thieu-b55/ESP32-clock-radio-with-web-interface/README.md

# ESP32-clock-radio

Fully operable via web page, only 1 push button to turn off the alarm 

*

Clock

Large and clear display.

Internal clock synchronized 2 x day with NTP server.

Time zone and winter / summer time correction manually via web page.

Adjustable clock display brightness.

*

clock radio

3 programmable alarms

* certain day
 
* daily

* weekdays

* weekend

mp3 player or internet radio as alarm source.

Possibility to be awakened by a freely selectable wake-up call.

Automatically turns off after 1 hour.

*

Internet radio

10 pre-programmed internet radios, can be changed via web page.

Tone and Volume control.

Continuous operation or as an alarm.

Random mp3 player 5000+ mp3 files without problem.
