thieu-b55/ESP32-clock-radio-with-web-interface/ESP32 wekkerradio(EN).pdf

## ESP32 clock - clock radio - internet radio / MP3 player -

control via web page.

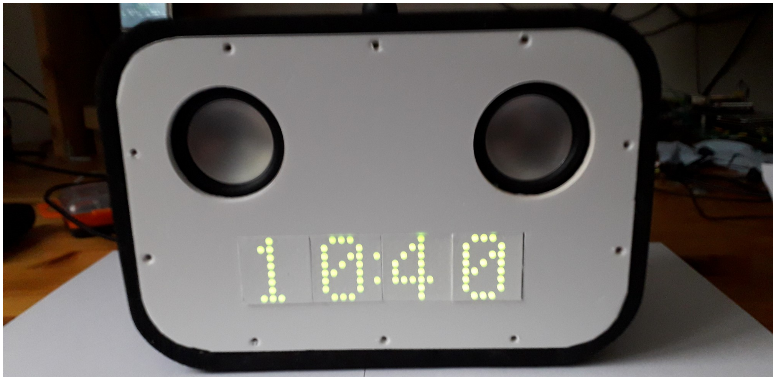
[picture p1: figure]

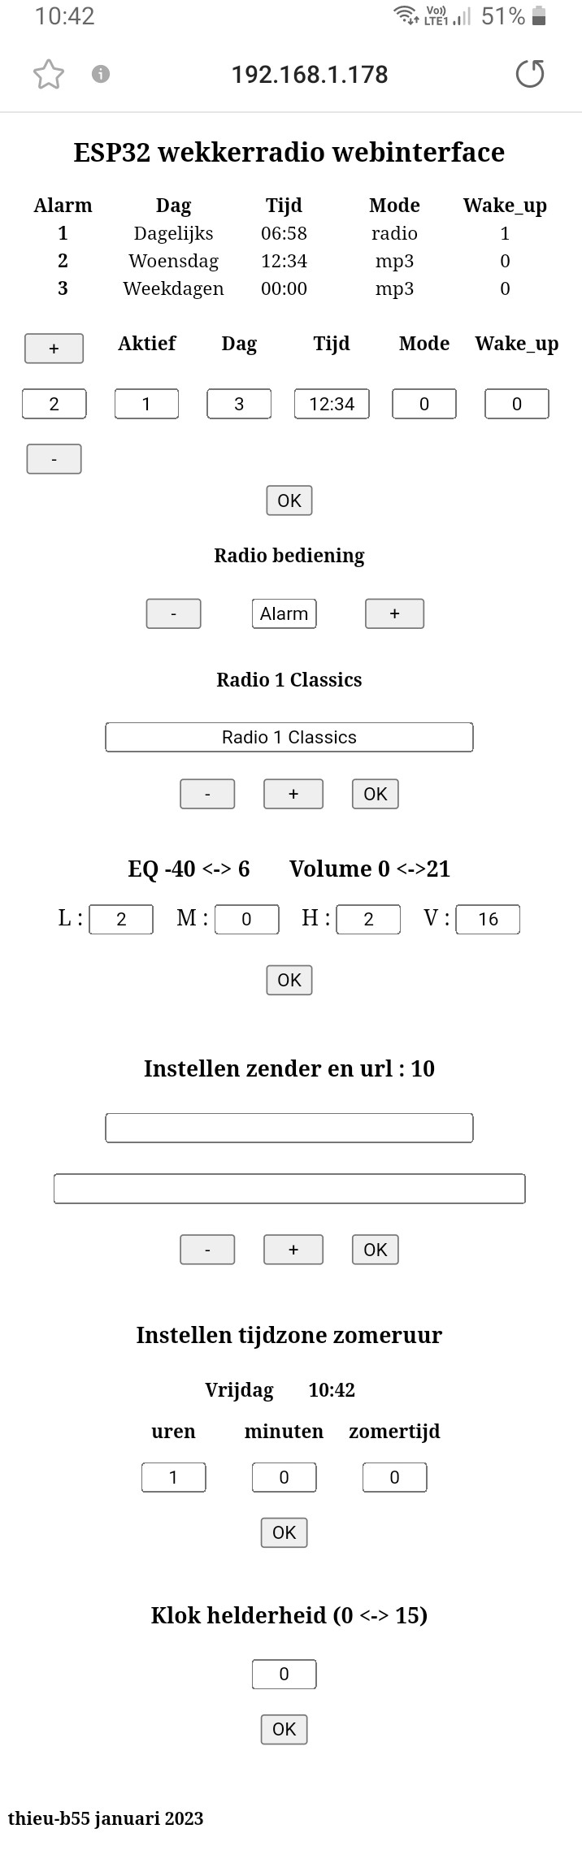
[picture p2: figure]

Clock
Large and clear display.
Internal clock synchronized 2 x day with NTP server.
Time zone and winter / summer time correction manually via web page. Adjustable clock display brightness.

clock radio
3 programmable alarms
* certain day
* daily
* weekdays
*weekend
mp3 player or internet radio as alarm source.
Possibility to be awakened by a freely selectable wake-up call. Automatically turns off after 1 hour.

Internet radio
10 pre-programmed internet radios, can be changed via web page. Tone and Volume control.
Continuous operation or as an alarm.
Random mp3 player 5000+ mp3 files without problem.

What do we need

ESP32-WROOM (38 pin versie)

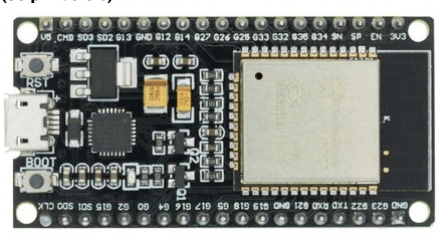
[picture p3: figure]

https://nl.aliexpress.com/item/32864722159.html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 %213.71%213.71%21%21%21%21%21%40210212c016740610529416210d0669%211200002874 4589167%21sea&curPageLogUid=wgT9nNbq322I (https://nl.aliexpress.com/item/32864722159.html?curPageLogUid=wgT9nNbq322I)

PCM5102A

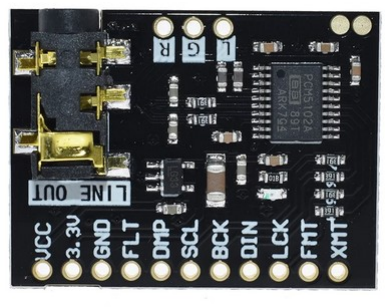
[picture p4: figure]

https://nl.aliexpress.com/item/33004561102.html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 %215.76%211.44%21%21%21%21%21%40212244c416740698615196556d0685%216711868056 6%21sea&curPageLogUid=zWKmpHWXxf05 (https://nl.aliexpress.com/item/33004561102.html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)

SD card module

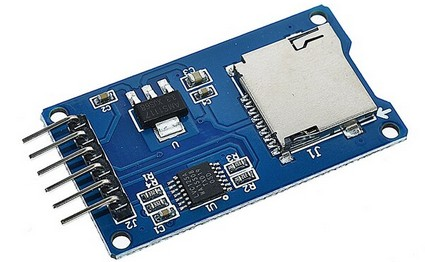
[picture p5: figure]

https://nl.aliexpress.com/item/32523546123.html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 %210.64%210.52%21%21%21%21%21%40212240a316740612452115676d0665%211000000248 6114694%21sea&curPageLogUid=oi29kmat1NDl (https://nl.aliexpress.com/item/32523546123.html?curPageLogUid=oi29kmat1NDl)

SD card FAT32 formatted
Depends on number of mp3 files, otherwise minimal size is sufficient.

DS3231 RTC

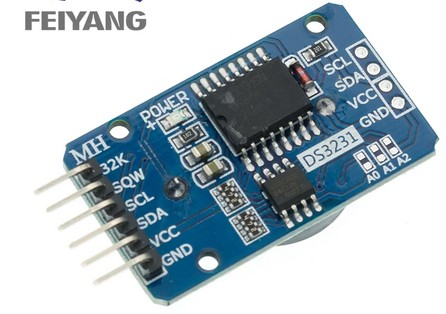
[picture p6: figure]

https://nl.aliexpress.com/item/32833136577.html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 %212.1%212.1%21%21%21%21%21%4021227a0f16740613309012224d06b3%2167454834461% 21sea&curPageLogUid=kFy3BkroDl2w (https://nl.aliexpress.com/item/32833136577.html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)

MAX7219 module

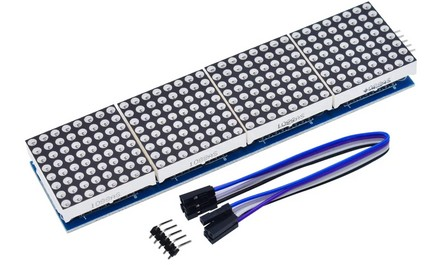
[picture p7: figure]

https://nl.aliexpress.com/item/4000587266290.html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 %214.49%213.69%21%21%21%21%21%402102111816740614473856175d0688%211000000343 9612437%21sea&curPageLogUid=RUunHGplwHcQ (https://nl.aliexpress.com/item/4000587266290.html?curPageLogUid=RUunHGplwHcQ)

Glasfolie wit mat
dimming brightness MAX7219 module https://www.gamma.be/nl/assortiment/decoratiefolie-mat-wit-346-0001-45x200cm/p/B389981

5V stereo versterker

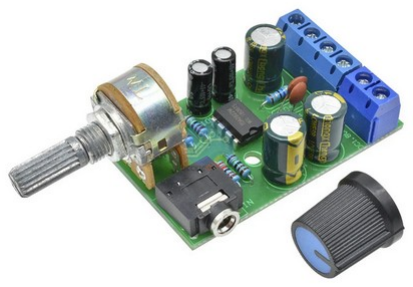
[picture p8: figure]

https://nl.aliexpress.com/item/32791319633.html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 %212.17%211.41%21%21%21%21%21%4021021aa216740618720378241d0701%216365064057 8%21sea&curPageLogUid=elbg0VoJ1Wxb (https://nl.aliexpress.com/item/32791319633.html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)

### 2 x luidspreker

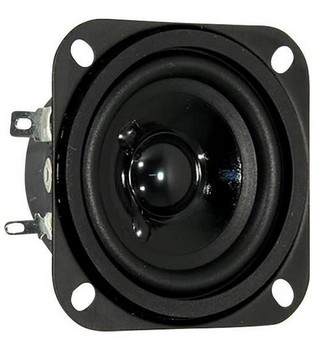
[picture p9: figure]

https://www.allekabels.be/luidspreker-zelfbouw/237/1370099/full-range-speaker-58-cm-23-8-10-w.html (https://www.allekabels.be/luidspreker-zelfbouw/237/1370099/full-range-speaker-58-cm-23-8-10-w.html)

Mosfet IRL540 / IRF540
IRL540L Vgs(th) | 1.0V | 2.0V
IRF540F Vgs(th) | 2.0V | 4.0V

IRF540 does what it should do, but if in stock IRL540 is recommended

R 1K
R 4K7

Pushbutton

5V (USB)power supply

1 x smartphone for operating radio / clock radio.

Internet connection is necessary

Connections

5V power supply
+5V | 5V | ESP32-WROOM
VCC | PCM5102A
VCC | MAX7219
DC+ | amplifier
GND | GND | ESP32-WROOM | 3X
GND | PCM5102A
GND | SD module
GND | RTC DS3231
GND | MAX7219
Source IRF(IRL)540 | amplifier ON/OFF

ESP32-WROOM
+5V | << | +5V | power supply
GND | << | GND | power supply
GND | << | GND | power supply
GND | << | GND | power supply
GND | >> | R4K7
+3.3V | >> | +3V3 SD module
| >> | VCC | DS3231RTC
>> | pushbutton alarm off
GPIO25 | >> | DIN | PCM5102A
GPIO26 | >> | LCK | PCM5102A
GPIO27 | >> | BCK | PCM5102A
GPIO5 | >> | CS | SD module
GPIO23 | >> | MOSI SD module
GPIO19 | >> | MISO SD module
GPIO18 | >> | SCK | SD module
GPIO21 | >> | SDA | DS3231
GPIO22 | >> | SCL | DS3231
GPIO32 | >> | SQW DS3231
GPIO15 | >> | CS | MAX7219
GPIO13 | >> | DIN | MAX7219
GPIO14 | >> | CLK | MAX7219
GPIO4 | >> | Pushbutton Alarm OFF
GPIO33 | >> | Gate | IRF(IRL)540 | amplifier ON/OFF

PCM5102A
5V | << | +5V | power supply
GND | << | GND | power supply
FLT | << | GND | PCM5102A
DMP | << | +3.3V | PCM5102A
SCL | << | GND | PCM5102A
BCK | << | GPIO27 | ESP32-WROOM
DIN | << | GPIO25 | ESP32-WROOM
LCK | << | GPIO26 | ESP32-WROOM
FMT | << | GND
XMT | << | +3.3V | PCM5102A
Audio
Left out | >> | Left in amplifier
Right out | >> | Right in amplifier
Do not connect GND-out to GND-in amplifier, amplifier is controlled by IRF540 via the GND

SD module
+3V3 | << | +3.3V | ESP32-WROOM
GND | << | GND | Voeding
CS | << | GPIO5 | ESP32-WROOM
MOSI | << | GPIO23 | ESP32-WROOM
MISO | << | GPIO19 | ESP32-WROOM
SCK | << | GPIO18 | ESP32-WROOM

DS3231 RTC
VCC | << | +3.3V | ESP32-WROOM
GND | << | GND | ESP32-WROOM
SDA | << | GPIO21 | ESP32-WROOM
SCL | << | GPIO22 | ESP32-WROOM
SQW | << | GPIO32 | ESP32-WROOM

MAX7219 module
VCC | << | +5V | power supply
GND | << | GND | power supply
CS | << | GPIO15 | ESP32-WROOM
DIN | << | GPIO13 | ESP32-WROOM
CLK | << | GPIO14 | ESP32-WROOM

Drukknop alarm uit
GPIO4 | << pushbutton N.O. << + 3.3V ESP32-WROOM
GPIO4 | << R 4K7 | << GND

Versterker
DC+ | << | +5V | power supply
DC- | << | Drain | IRF540 (IRL540)
Left in | << | Left out | PCM5102A
Right in | << | Right out | PCM5102A
DO NOT CONNECT AUDIO GROUND

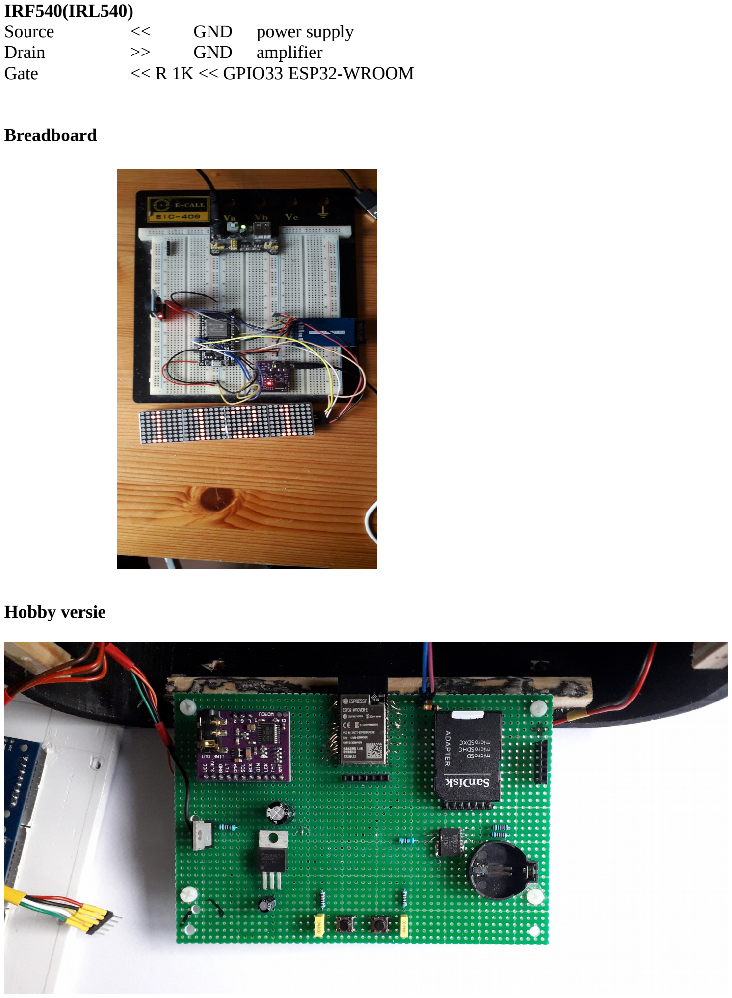
[picture p10: page 10]

IRF540(IRL540)
Source | << | GND | power supply
Drain | >> | GND | amplifier
Gate | << R 1K << GPIO33 ESP32-WROOM

Breadboard

Hobby versie

If desired, stick 1 or more layers of foil (see 'what do we need' above) on the MAX7219 module to reduce the light intensity.

Go to https://github.com/thieu-b55/ESP32-clock-radio-with-web-interface

download het zipbestand : | SD card files.zip en unzip.
download het programma : | ESP32_webradio_WROOM_wekker.ino

Copy the files you find in the SD card files folder to the SD card and place the SD card in the SD card holder.

Open the program ESP32_webradio_WROOM_wekker.ino with the Arduino IDE.

Settings of the Arduino IDE see screen print. Port setting depends on your configuration.

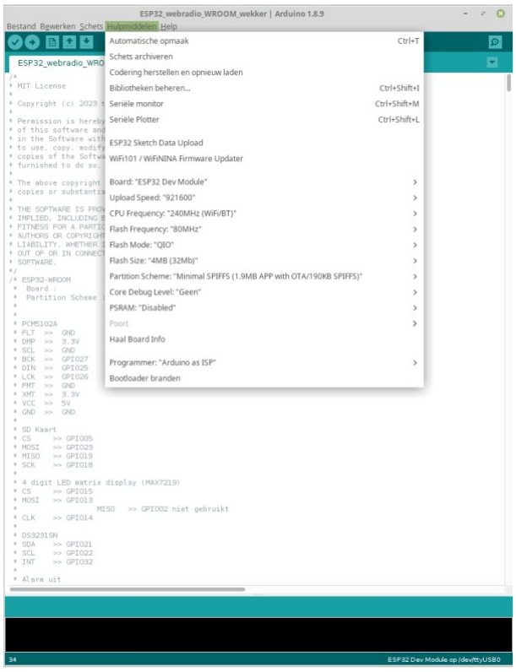
[picture p11: figure]

Upload programma in ESP32-WROOM

On 1st use : connect to

network : ESP32klok
password : ESP32pswd

Open webpage on address 192.168.4.1

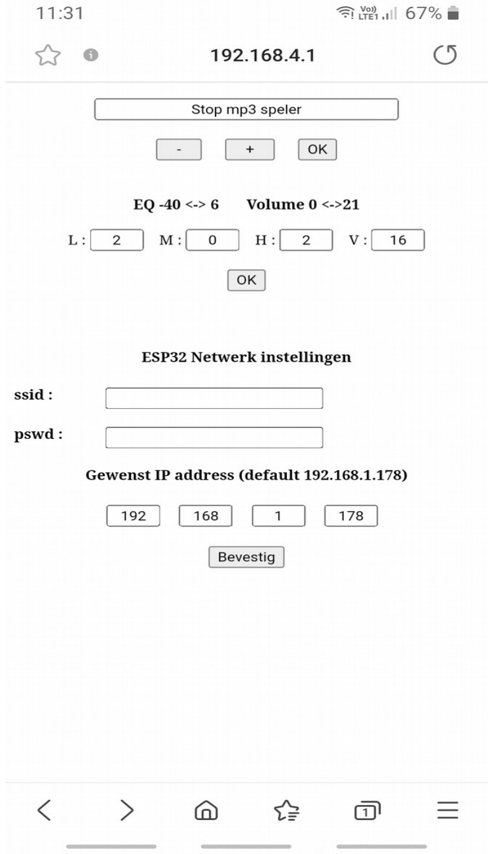
[picture p12: figure]

Below ESP Netwerk instellingen ssid
pswd
fill in of home network.

Below Gewenst IP address ...
if desired, a different IP address can be entered here. Take the range of the modem into account.

After <Bevestig> ESP32 restarts automatically, if everything has been entered correctly, the network ESP32klok is no longer available.
Reconnect to your home network and go to 192.168.1.178, or to the IP address of your choice.

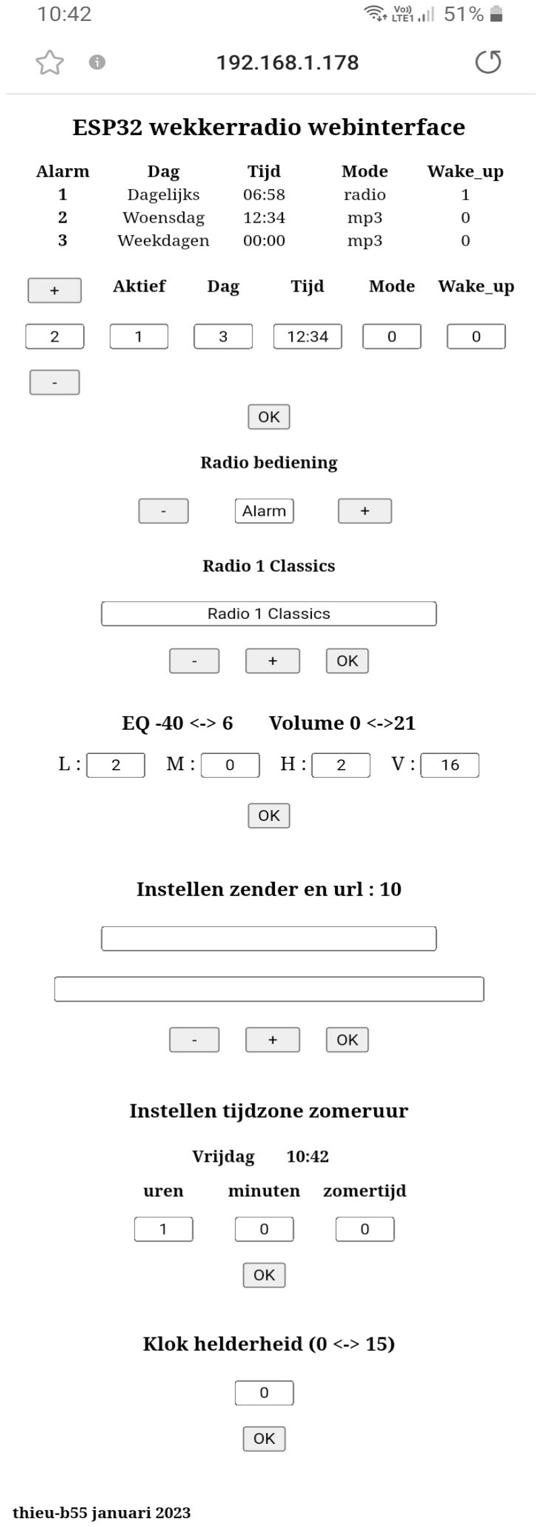
[picture p13: figure]

Hoe werkt het :

Clock radio
3 aktieve alarmen

1 aktief alarm

In this box on the web page we see which alarms are active and what the settings are. Only the active alarms are shown.

Set alarms

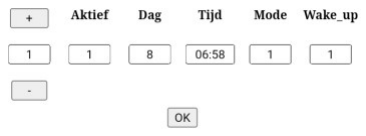
[picture p14: figure]

In this box we can set the 3 alarms. + moves to the next alarm
– to the previous alarm

Aktief
0 alarm not active
1 alarm active

Dag
Which day(s) should be alerted
1: Monday 2: Tuesday 3: Wednesday 4: Thursday 5: Friday 6: Saturday 7: Sunday 8: daily 9: weekdays 10: weekend

Tijd
Hour and minutes of alarm start

Mode
0 mp3 player. Make sure that the mp3 list has been created, see further in the manual. 1 internetradio

Wake_up
0 geen wake_up
1 if there is a file wake_up.mp3 in the root of the SD card, it will be opened first before switching to mp3 player or internet radio

Acceptwith OK

Radio/mp3 alarm of aan

+/- kiezen Alarm of Aan
Alarm radio/mp3 player plays when there is an alarm
Aan radio/mp3 player plays as long as On is selected. Alarms are not working now.

Silence alarm using push button connected to GPIO4 of ESP32
Alarm turns itself off after 1 hour
To switch off the alarm permanently, set the alarm to inactive.

Set time zone summer/winter time

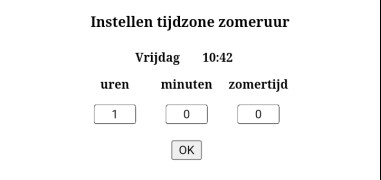
[picture p15: figure]

uren | hours deviation from UTC time + or –
minuten | minutes deviation from UTC time (0 or 30)
zomertijd | 1 = summer time 0 = winter time
Accept with OK

Light intensity

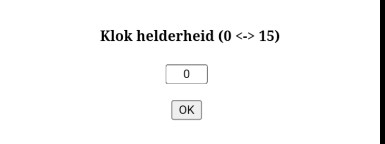
[picture p16: figure]

Enter the desired brightness of the display here. Value from 0 to 15.

Accept with OK

How does it work :

Channel selection
Choosing another channel when the radio is in Alarm mode is not always possible, it is best to put the radio in the On position before wanting to change channels.

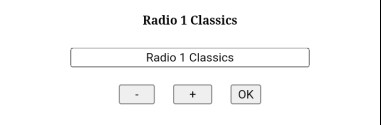
[picture p17: figure]

Radio 1 Classics is radio that is currently playing.
If title and performer are available, they will be shown below.

selection box
Radio 1 Classics is now in the selection box, using the + and – button you can select another station. Accept with OK

In the selection list there is also the option to create mp3 list and mp3 player, more about this later in the manual.

Volume en EQ

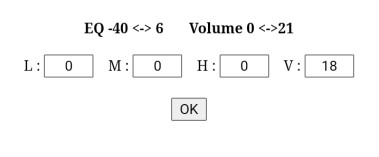
[picture p18: figure]

L : laag
M: midden
H: hoog

V: volume

L M H kan je instellen tussen -40 en 6 V kan je instellen tussen 0 en 21 bevestigen met <OK>

Set channels

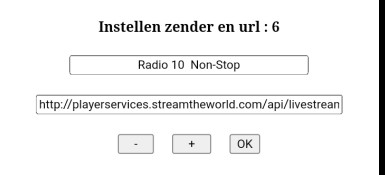
[picture p19: figure]

Already set channels or still empty positions can be changed as desired. Maximum channels that can be set is 10.
In the first box under <Set channel and url : ..> you can enter a random name for the channel. The web address of the sender must be entered in the second box.
moving to a next or previous position is done with the <-><+> keys.

Accept with <OK>,

mp3 speler.
It is best to put the radio in the On position and not in the Alarm position before reading the mp3 files.

Before listening to mp3 files, song lists must first be created.
With a large number of mp3 files, it is advisable to divide them evenly into different folders. Starting from mp3_0 and so on mp3_1, mp3_2.
These numbers must follow each other. Program stops searching if the following mp3_X folder does not exist.
It is best to have about as many files in each mp3_X folder as there are mp3_X folders.
so with 900 mp3's this gives 30 mp3_X folders with 30 mp3 files each.
SD program reads sequentially and in this way it takes the fewest number of reads to find the last mp3 file.

Important:
If this is not the 1st time you are making an mp3 list, you must first delete all songlistx folders from the SD card.

Screenshot of SD card with mp3_. folders that have not yet been imported.

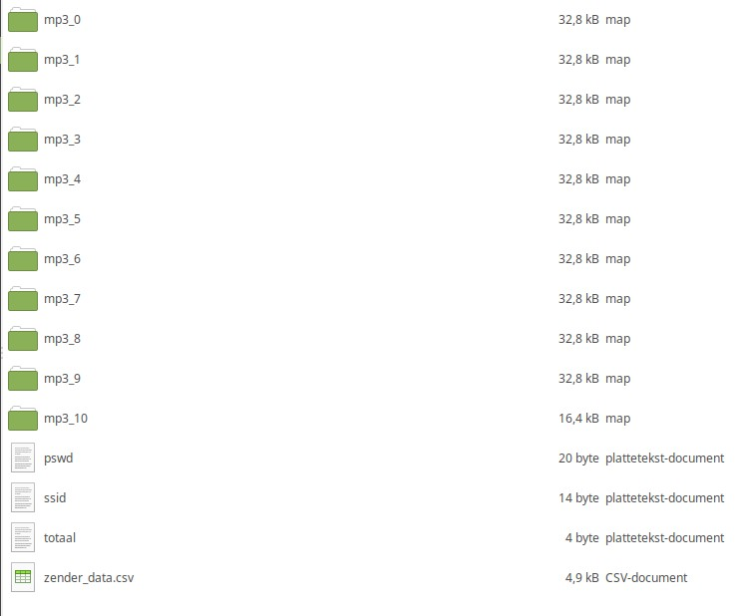
[picture p20: figure]

Once you've copied all your mp3s to the SD card and deleted any songlistx folders, put the SD card back in its slot.

In the channel selection section go to <mp3 lijst maken> and press <OK>

Reading starts.

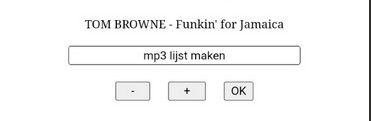
[picture p21: figure]

The program needs about 2 minutes per 1000 mp3 files if they are evenly distributed over several mp3_X folders as described above.
The progress of the import can be followed by pressing the refresh circle at the top right of the web page.

After reading all mp3 files, the program switches to mp3 player

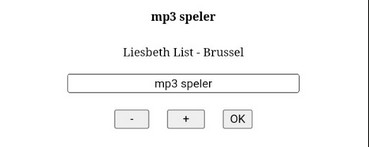
[picture p22: figure]

Screenshot of the SD card after reading the mp3_.. folders

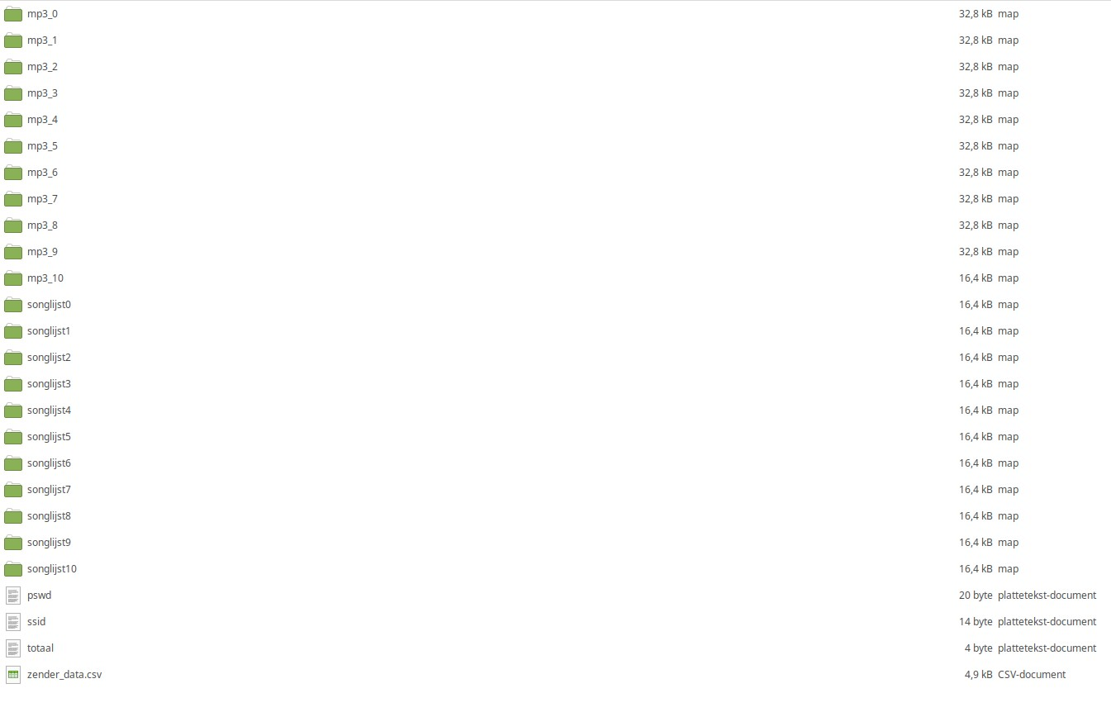
[picture p23: figure]

Important:
to avoid a possible endless loop in the event of an error during mp3 playback, it will always start up as a web radio after a reset or power failure.

So that was about it,
greetings and happy listening, thieu-b55
