thieu-b55/ESP32-clock-radio-with-web-interface/wekkerradio.png

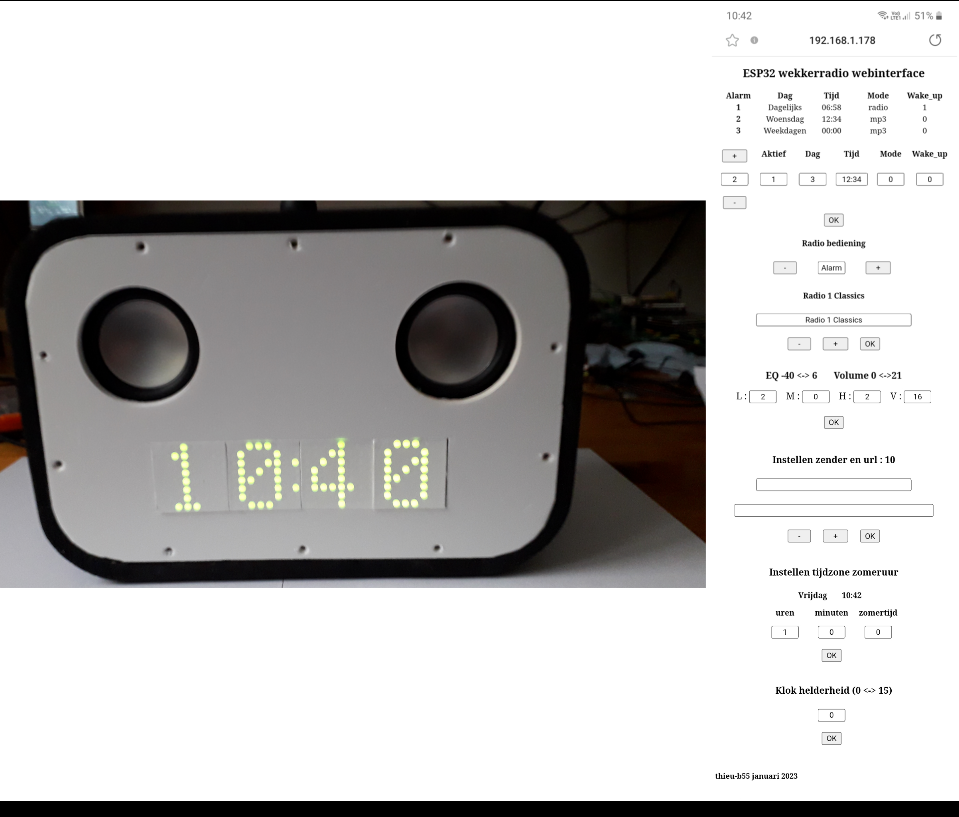
wekkerradio.png
